MarcinWachowiak/plasma-speaker/README.md

# Plasma-Speaker

https://hackaday.io/project/160041-plasma-speaker-exploring-properties-of-plasma
