MarcinWachowiak/plasma-speaker/Plasma speaker poster.pdf

# “Plasma speaker: Plasma and it's unusual properties”

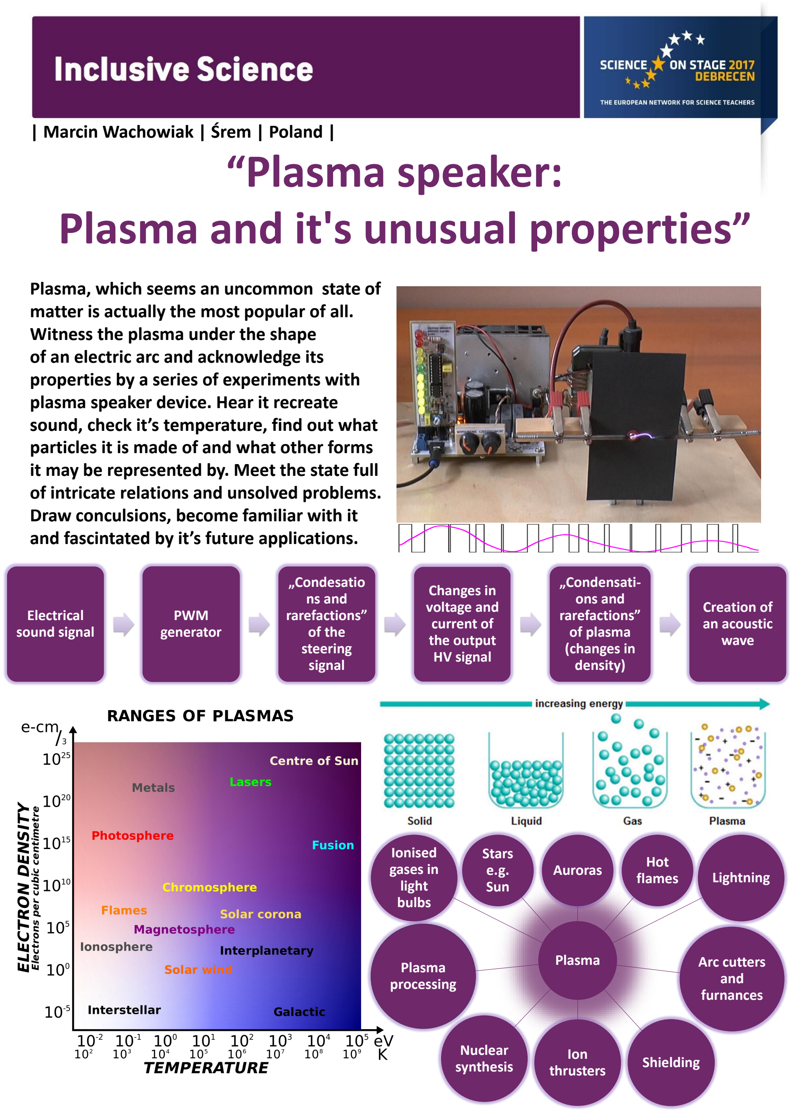
[picture p1: page 1]

| Marcin Wachowiak | Śrem | Poland |

Plasma, which seems an uncommon state of matter is actually the most popular of all. Witness the plasma under the shape
of an electric arc and acknowledge its properties by a series of experiments with plasma speaker device. Hear it recreate sound, check it’s temperature, find out what particles it is made of and what other forms it may be represented by. Meet the state full of intricate relations and unsolved problems. Draw conculsions, become familiar with it and fascintated by it’s future applications.

Electrical
sound signal

PWM
generator

„Condesatio
ns and
rarefactions”
of the
steering
signal

Changes in
voltage and
current of
the output
HV signal

„Condensations and
rarefactions”
of plasma
(changes in
density)

Creation of
an acoustic
wave

Plasma

Hot
flames

Stars
e.g.
Sun

Auroras
Lightning

Ionised
gases in
light
bulbs

Shielding

Plasma
processing

Nuclear
synthesis

Ion
thrusters

Arc cutters
and
furnances
