MarcinWachowiak/plasma-speaker/Plasma speaker presentation.pdf

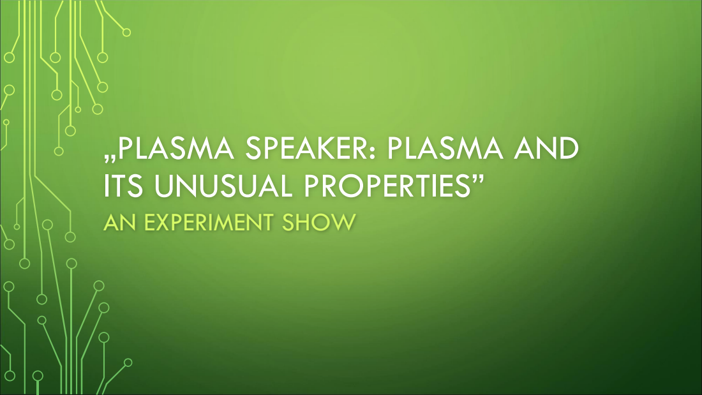
[picture p2: page 1]

„PLASMA SPEAKER: PLASMA AND
ITS UNUSUAL PROPERTIES”
AN EXPERIMENT SHOW

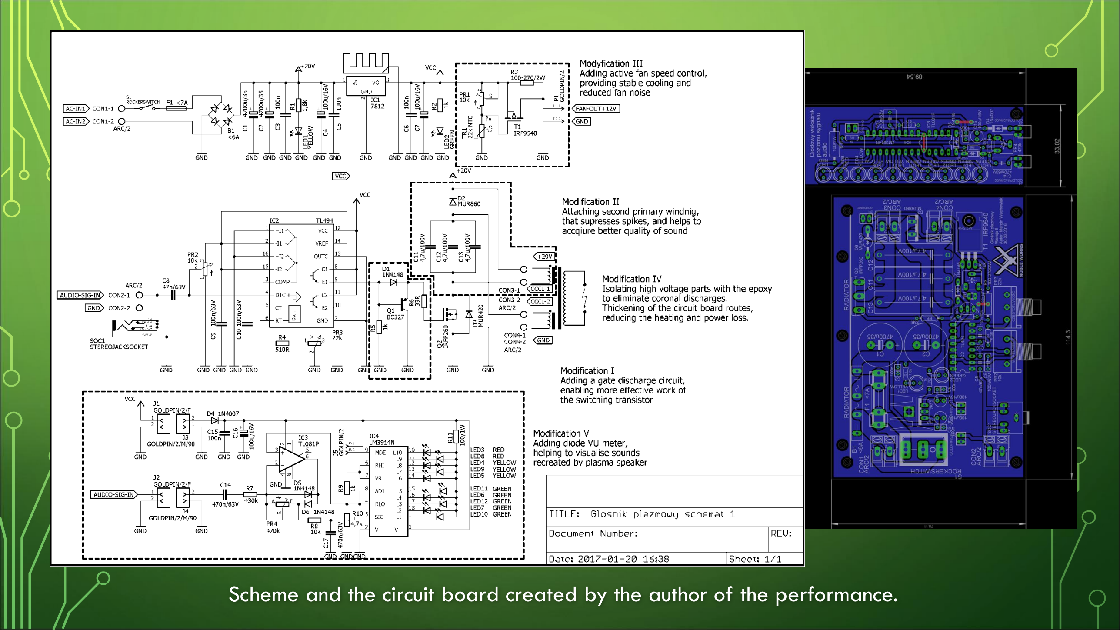
[picture p3: page 2]

Scheme and the circuit board created by the author of the performance.

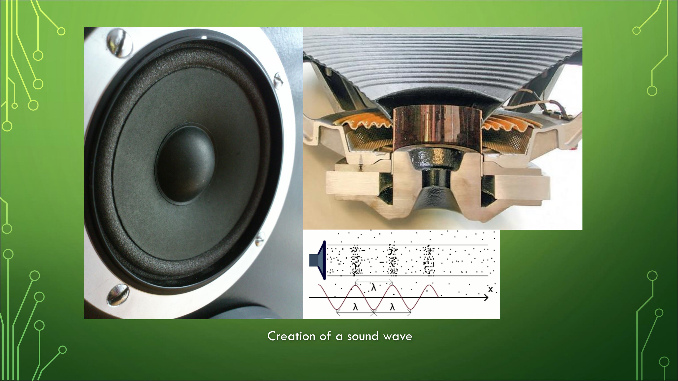
[picture p4: page 3]

## Creation of a sound wave

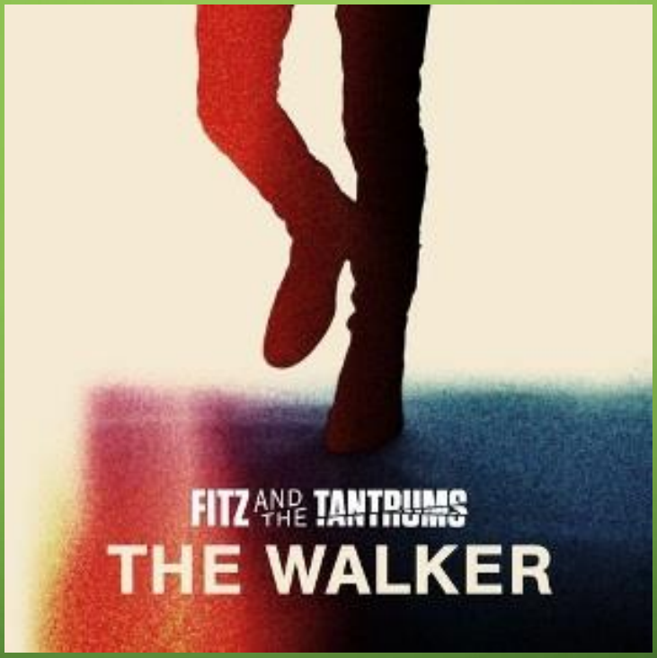
[picture p5: figure]
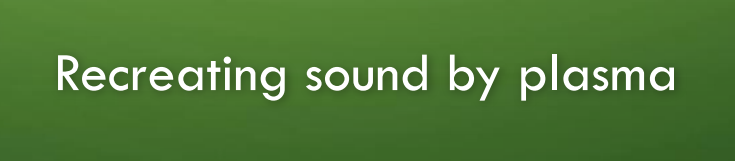
[picture p6: figure]
Recreating sound by plasma
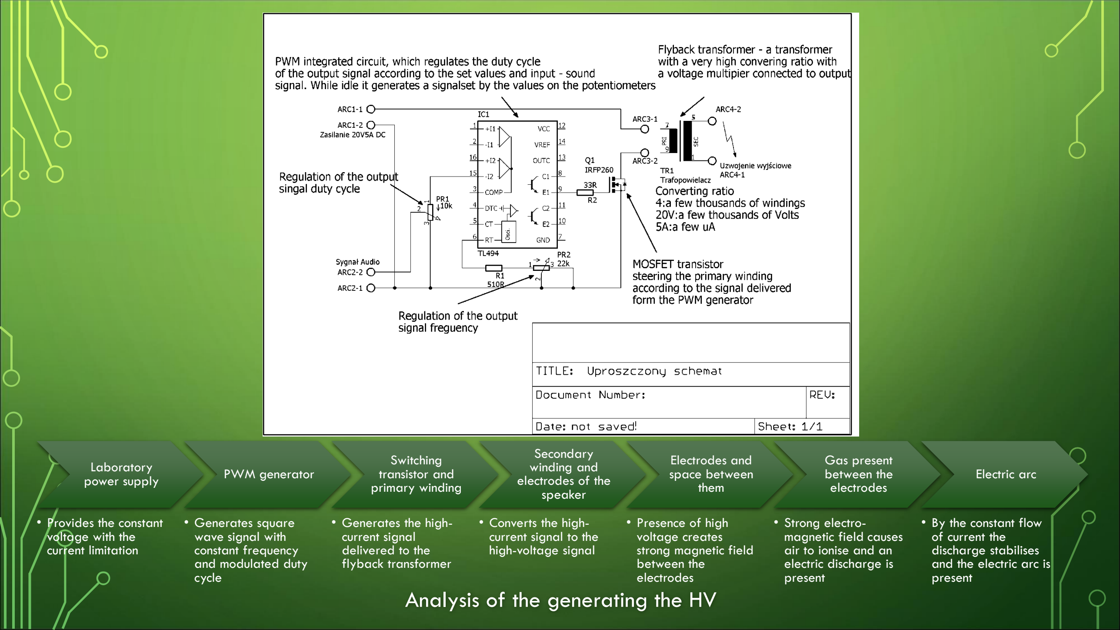
[picture p7: page 5]

Laboratory
power supply
- Provides the constant
voltage with the
current limitation

PWM generator

- Generates square
wave signal with
constant frequency
and modulated duty
cycle

Switching
transistor and
primary winding
- Generates the highcurrent signal
delivered to the
flyback transformer

Secondary
winding and
electrodes of the
speaker
- Converts the highcurrent signal to the
high-voltage signal

Electrodes and
space between
them
- Presence of high
voltage creates
strong magnetic field
between the
electrodes

Gas present
between the
electrodes
- Strong electromagnetic field causes
air to ionise and an
electric discharge is
present

Electric arc

- By the constant flow
of current the
discharge stabilises
and the electric arc is
present

## Analysis of the generating the HV

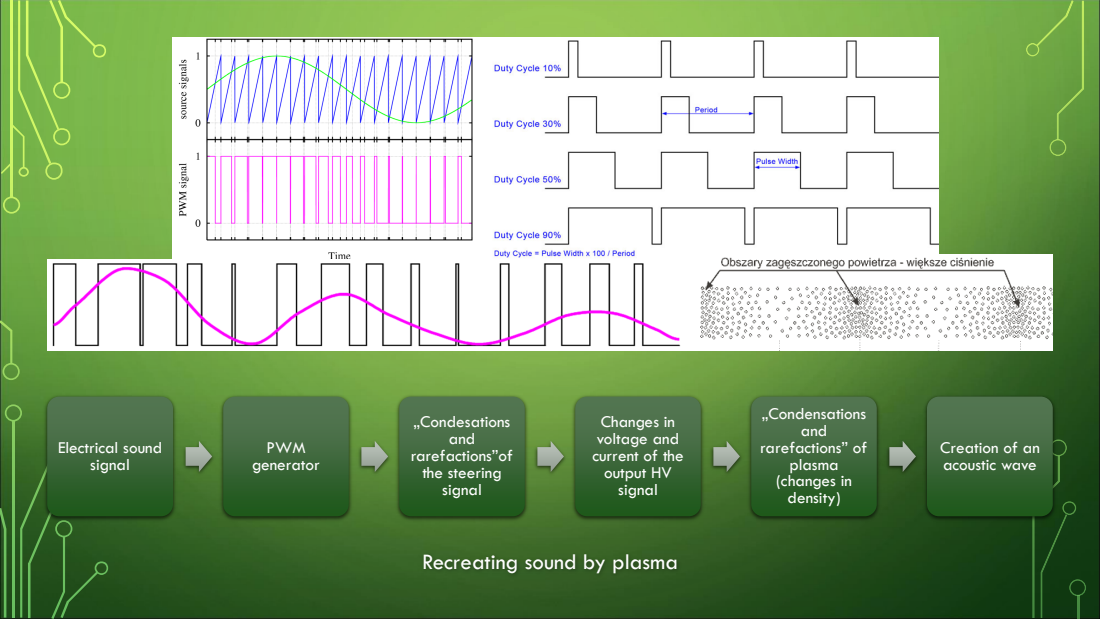
[picture p8: page 6]
Electrical sound signal; PWM generator; „Condesations and rarefactions”of the steering signal; „Condensations and rarefactions” of plasma (changes in density

Changes in
voltage and
current of the
output HV
signal

Creation of an
acoustic wave

Recreating sound by plasma

# Similarities

# Differences

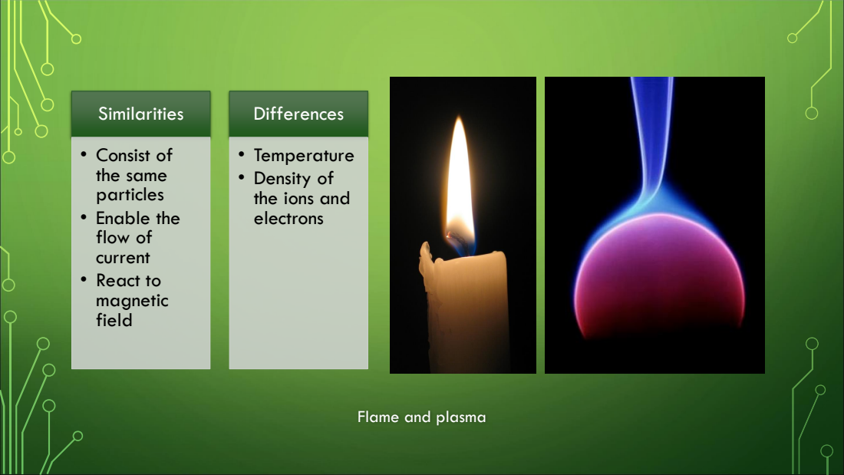
[picture p9: page 7]
• Consist of the same particles • Enable the flow of current • React to magnetic field

• Temperature
• Density of
the ions and
electrons

Flame and plasma

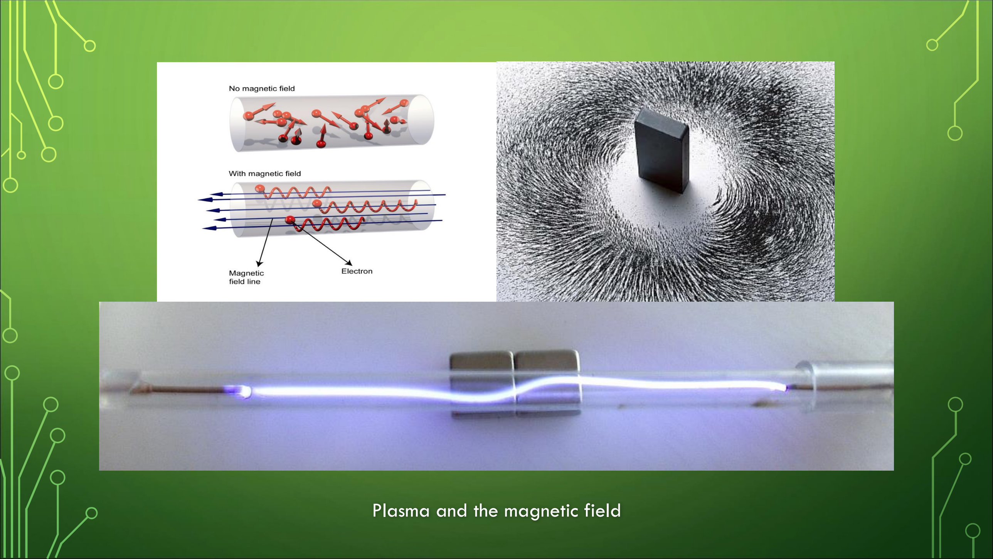
[picture p10: page 8]

## Plasma and the magnetic field

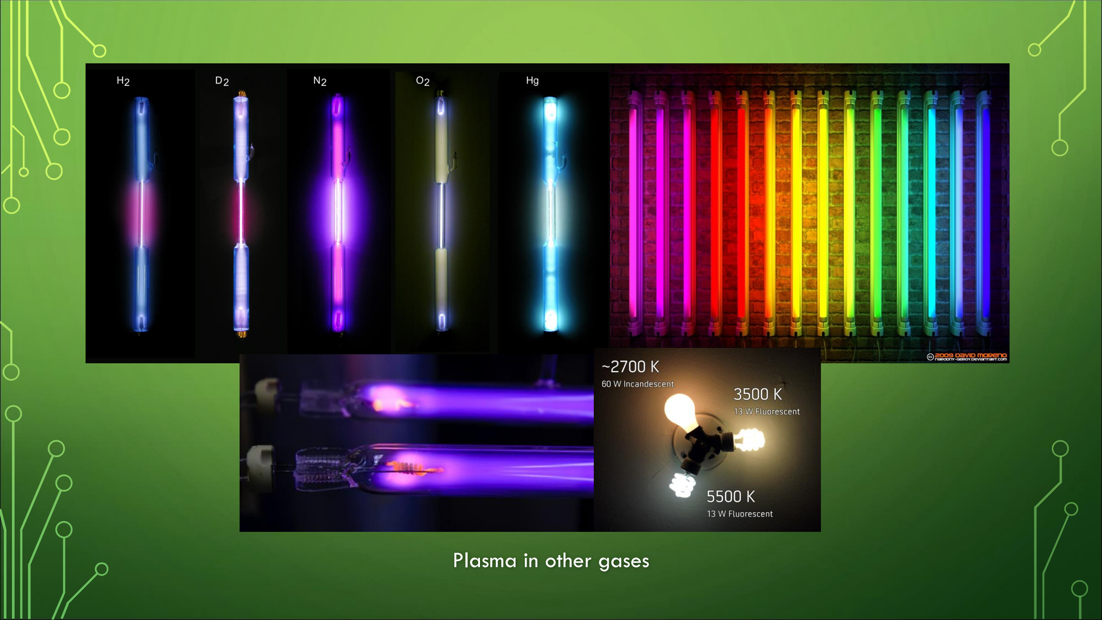
[picture p11: page 9]

## Plasma in other gases

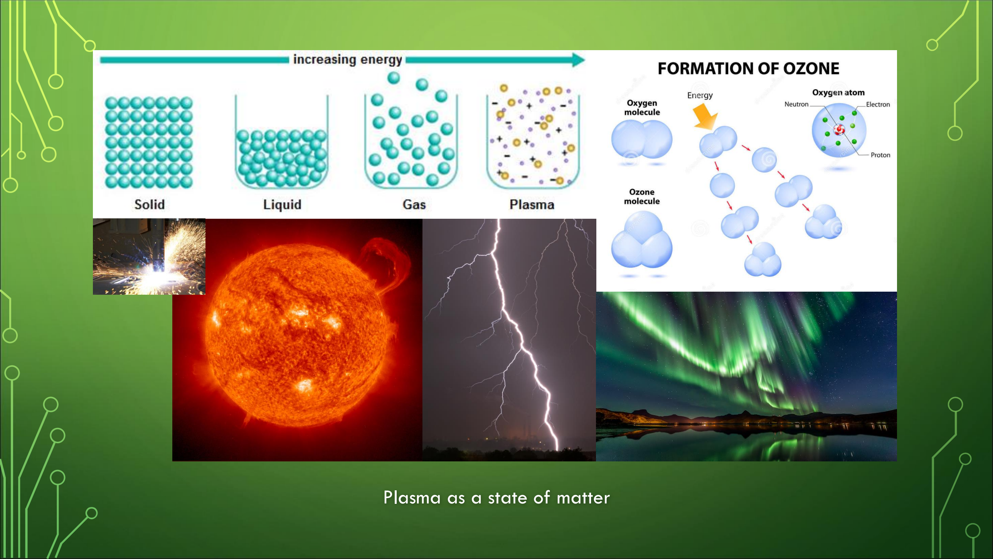
[picture p12: page 10]

## Plasma as a state of matter

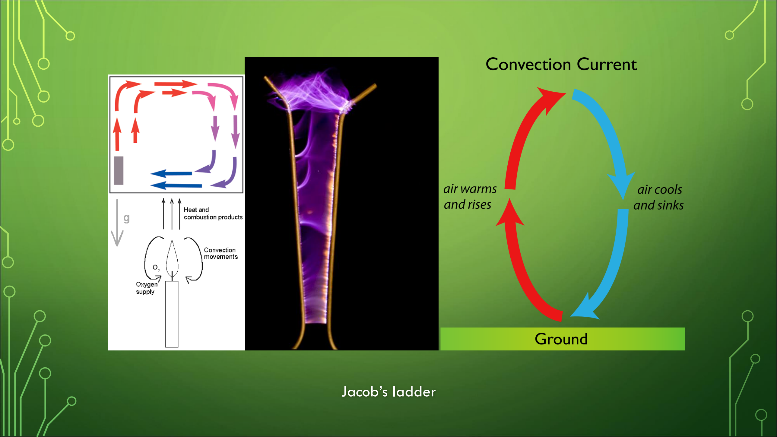
[picture p13: page 11]

## Jacob’s ladder

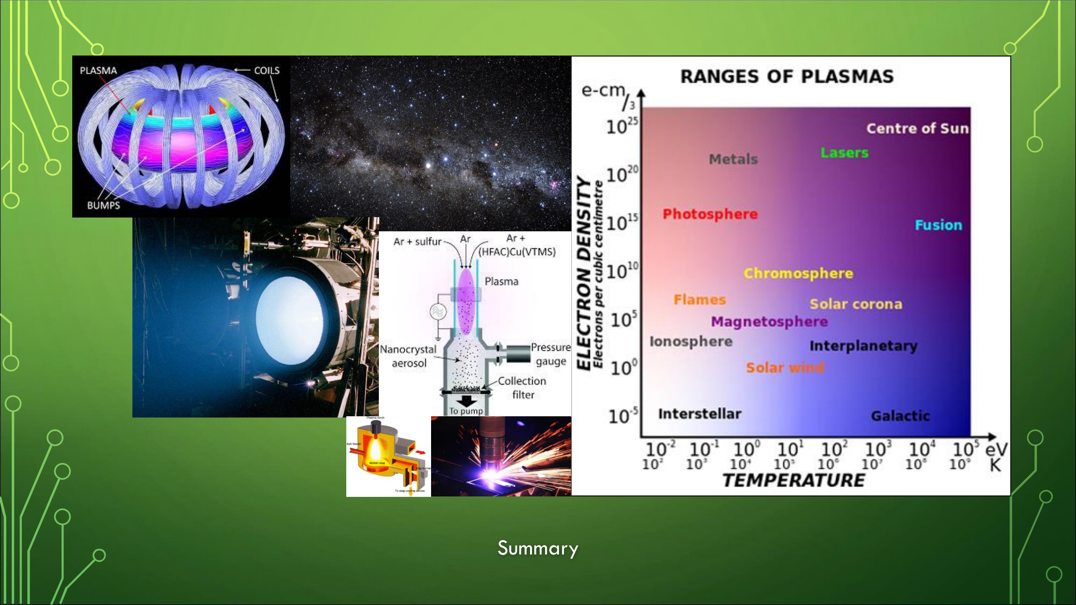
[picture p14: page 12]

## Summary

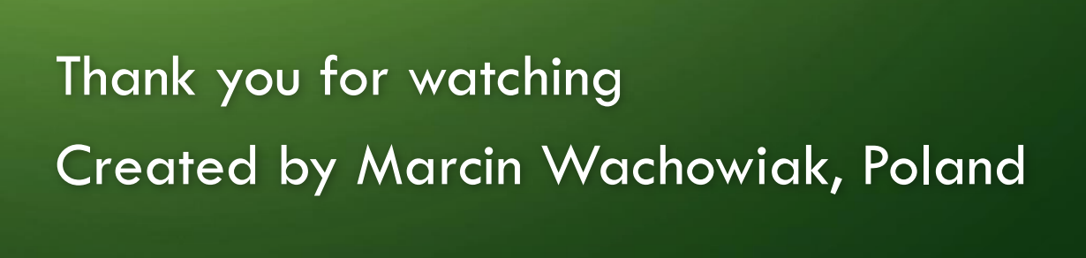
[picture p15: figure]
Thank you for watching; Created by Marcin Wachowiak, Poland
