MarcinWachowiak/plasma-speaker/Brd.png

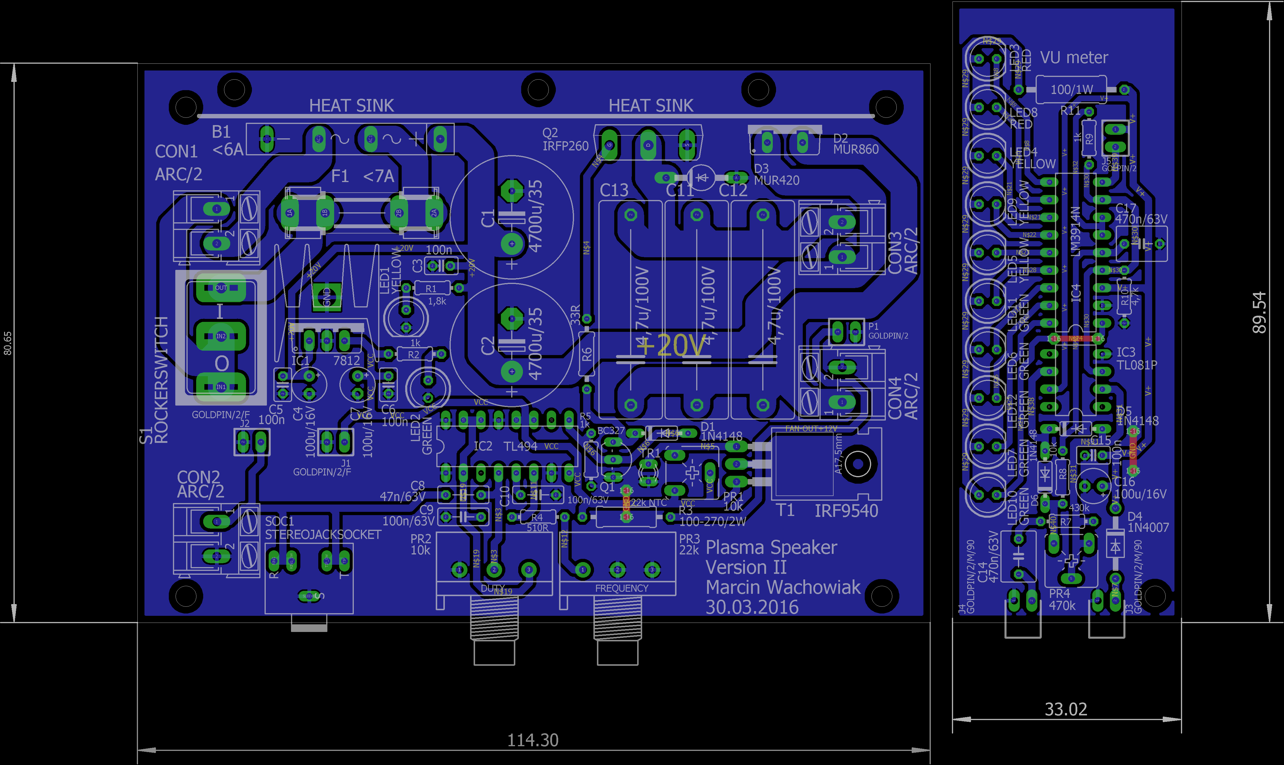
Brd.png
