MarcinWachowiak/plasma-speaker/Sch1.png

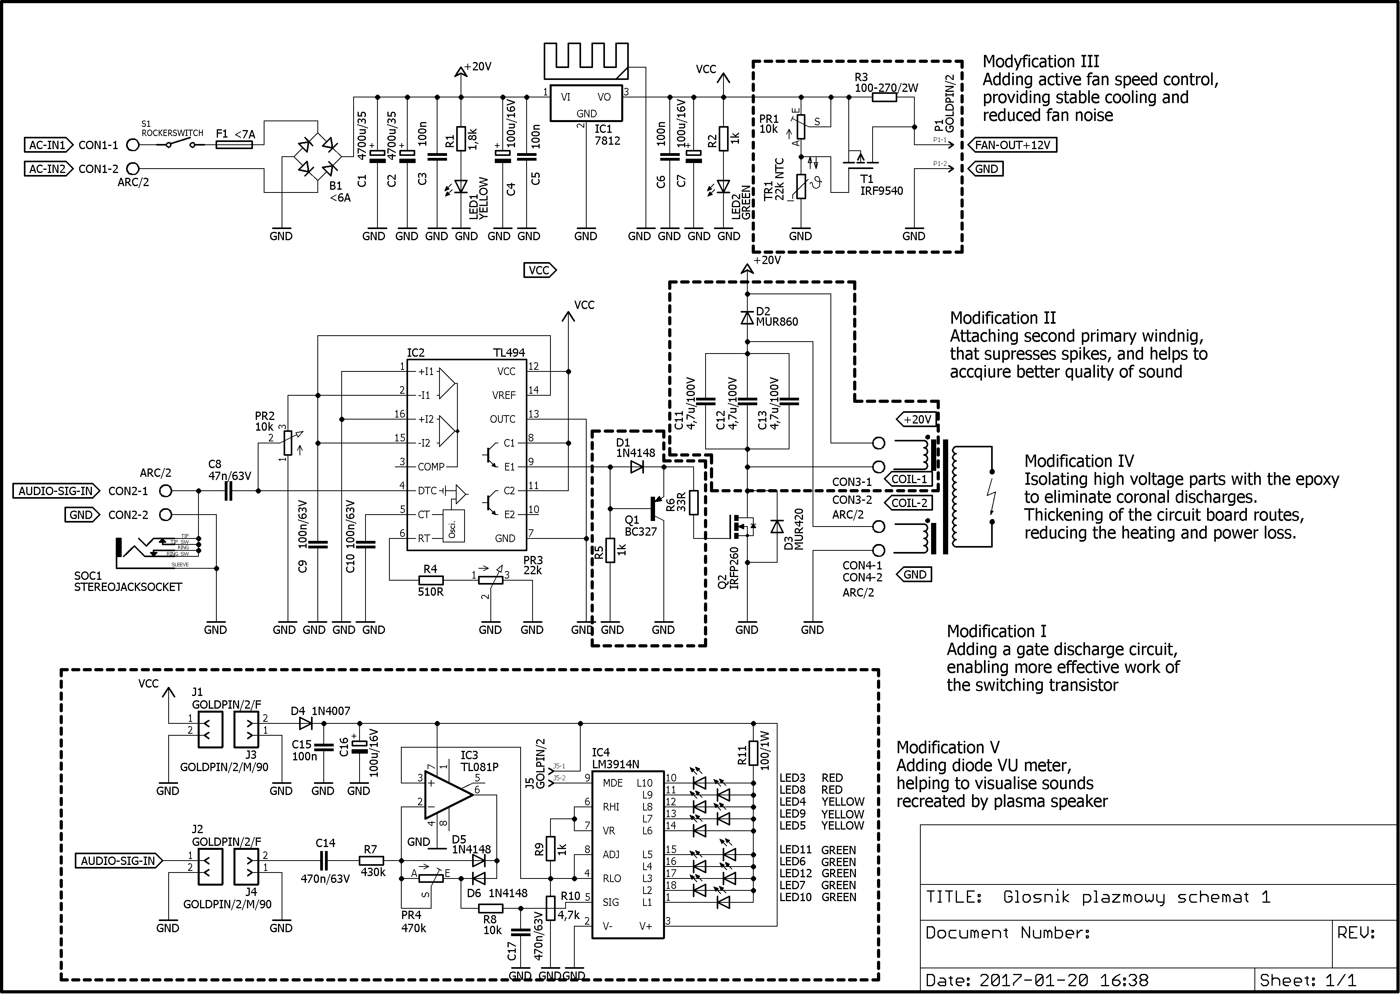
Sch1.png
