MarcinWachowiak/plasma-speaker/Sch2.png

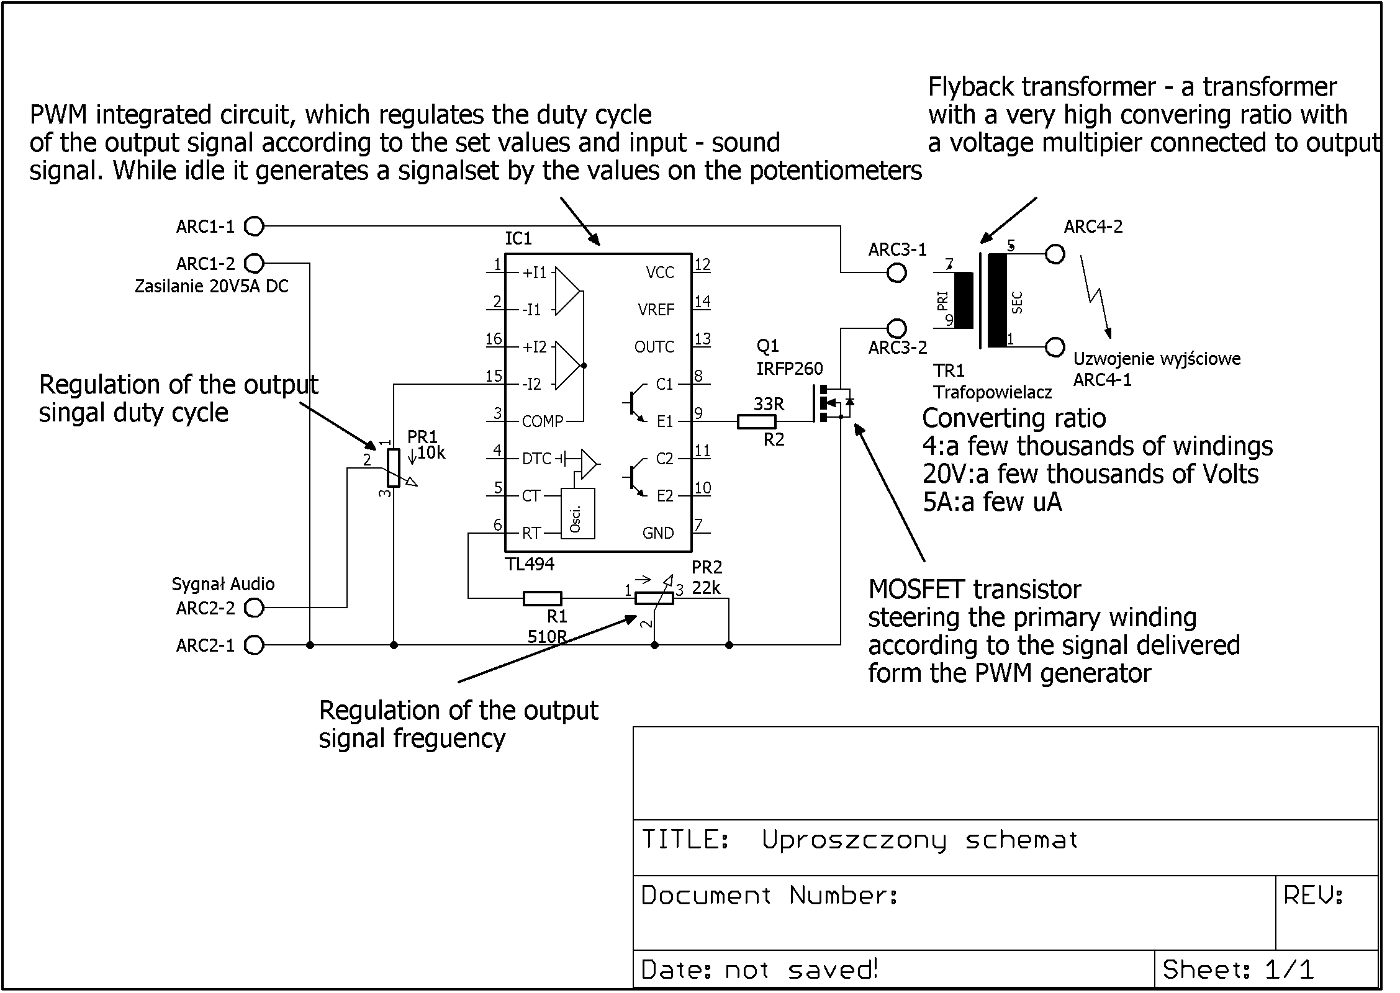
Sch2.png
