MarcinWachowiak/plasma-speaker/Plasma speaker.brd

## EAGLE design Plasma speaker.brd (2018-07-29)

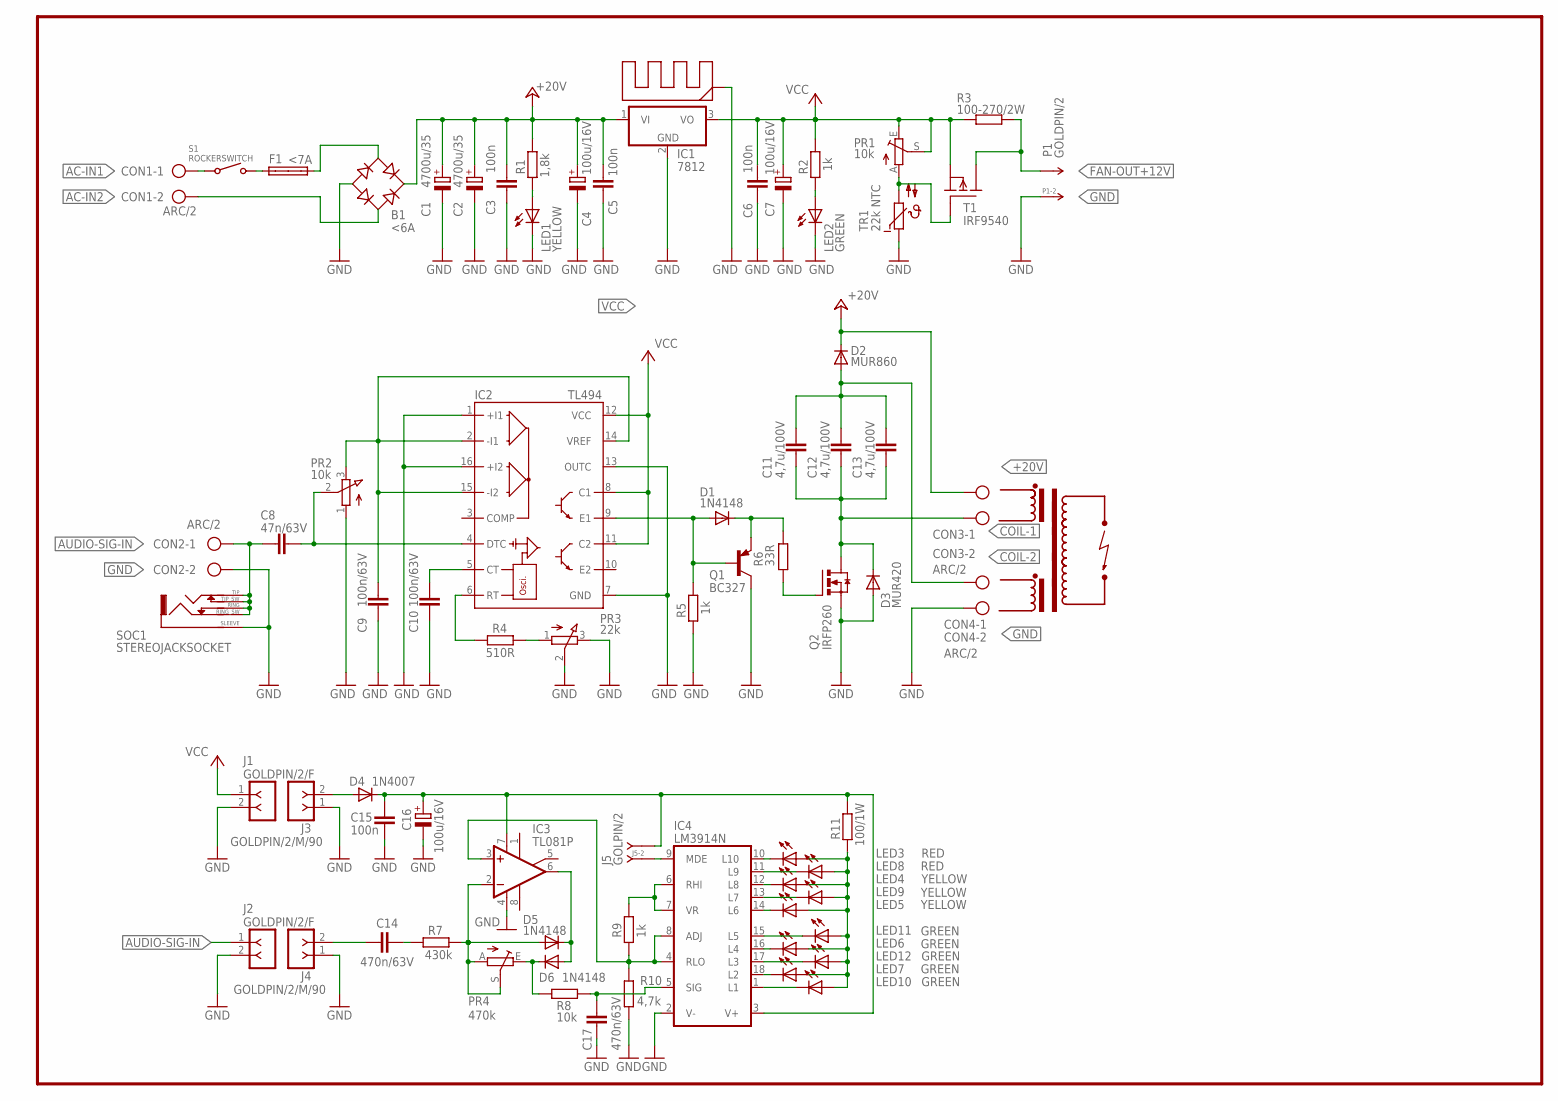
[picture p22: schematic Plasma speaker.sch]

Parts:
B1: <6A; SKB32
C1, C2: 4700u/35; E7,5-18
C3, C5, C6, C15: 100n; C025-025X050
C4, C7, C16: 100u/16V; E2,5-5
C8: 47n/63V; C050-025X075
C9, C10: 100n/63V; C050-025X075
C11, C12, C13: 4,7u/100V; C275-093X316
C14, C17: 470n/63V; C050-050X075
CON1, CON2, CON3, CON4: ARC/2; AK300/2
D1, D5, D6: 1N4148; DO35-7
D2: MUR860; TO220ACS
D3: MUR420; SGA-10
D4: 1N4007; DO41-10
F1: <7A; SHK20L
IC1: 7812; TO220V
IC2: TL494; DIL16
IC3: TL081P; DIL08
IC4: LM3914N; DIL18
J1, J2: GOLDPIN/2/F; SIP-100-02-40Y
J3, J4: GOLDPIN/2/M/90; KK-4455-A02
J5: GOLPIN/2; SIP-100-02-40Y
LED1, LED4, LED5, LED9: YELLOW; LED5MM
LED2, LED6, LED7, LED10, LED11, LED12: GREEN; LED5MM
LED3, LED8: RED; LED5MM
P1: GOLDPIN/2; SIP-100-02-40Y
PR1: 10k; CA6V
PR2: 10k; 3RP/1610N
PR3: 22k; 3RP/1610N
PR4: 470k; CA6V
Q1: BC327; TO92-EBC
Q2: IRFP260; TO247BV
R1: 1,8k; 0204/7
R2, R5, R9: 1k; 0204/7
R3: 100-270/2W; 0309/12
R4: 510R; 0204/7
R6: 33R; 0207/10
R7: 430k; 0204/7
R8: 10k; 0204/7
R10: 4,7k; 0204/7
R11: 100/1W; 0411/15
RAD1: TO3; RADIATOR
S1: ROCKERSWITCH; ROCKER
SOC1: STEREOJACKSOCKET; PICAXE_STEREOJACKSOCKET
T1: IRF9540; TO220
TR1: 22k NTC; P640

Connections:
+20V: B1.+, C1.+, C2.+, C3.1, C4.+, C5.1, CON3.1, D2.C, IC1.1 (VI), R1.1
AC-IN1: CON1.1, S1.IN1 (IN), S1.IN2 (IN)
AC-IN2: B1.AC2, CON1.2
AUDIO-SIG-IN: C8.2, CON2.1, J2.1, SOC1.RING, SOC1.RING_SW (RING-SW), SOC1.TIP, SOC1.TIP_SW (TIP-SW)
COIL-1: C11.2, C12.2, C13.2, CON3.2, D3.C, Q2.D
COIL-2: C11.1, C12.1, C13.1, CON4.1, D2.A
FAN-OUT+12V: P1.1, R3.2, T1.2 (D)
GND: B1.-, C1.-, C2.-, C3.2, C4.-, C5.2, C6.2, C7.-, C9.2, C10.2, C15.2, C16.-, C17.1, CON2.2, CON4.2, D3.A, IC1.2 (GND), IC2.1 (+I1), IC2.7 (GND), IC2.13 (OUTC), IC2.16 (+I2), IC3.4 (V-), IC4.2 (V-), J1.2, J2.2, J3.1, J4.1, LED1.K (C), LED2.K (C), P1.2, PR2.1 (A), PR3.2 (S), PR3.3 (E), Q1.C, Q2.S, R5.1, R10.2, RAD1.GND, SOC1.SLEEVE, TR1.1
unnamed: B1.AC1, F1.2A
unnamed: C14.1, J4.2
unnamed: C8.1, IC2.4 (DTC), PR2.2 (S)
unnamed: Q2.G, R6.1
unnamed: PR1.A, T1.1 (G), TR1.2
unnamed: D1.A, IC2.9 (E1), Q1.B, R5.2
unnamed: D4.A, J3.2
unnamed: IC4.10 (L10), LED3.K (C)
unnamed: C10.1, IC2.5 (CT)
unnamed: IC2.6 (RT), R4.2
unnamed: PR3.1 (A), R4.1
unnamed: D1.C, Q1.E, R6.2
unnamed: F1.1A, S1.OUT
unnamed: LED2.A, R2.2
unnamed: LED1.A, R1.2
unnamed: C9.1, IC2.2 (-I1), IC2.14 (VREF), IC2.15 (-I2), PR2.3 (E)
unnamed: IC4.11 (L9), LED8.K (C)
unnamed: IC4.12 (L8), LED4.K (C)
unnamed: IC4.13 (L7), LED9.K (C)
unnamed: IC4.14 (L6), LED5.K (C)
unnamed: IC4.1 (L1), LED10.K (C)
unnamed: IC4.18 (L2), LED7.K (C)
unnamed: IC4.17 (L3), LED12.K (C)
unnamed: IC4.16 (L4), LED6.K (C)
unnamed: IC4.15 (L5), LED11.K (C)
unnamed: LED3.A, LED4.A, LED5.A, LED6.A, LED7.A, LED8.A, LED9.A, LED10.A, LED11.A, LED12.A, R11.1
unnamed: IC3.3 (+IN), IC4.4 (RLO), IC4.8 (ADJ), R9.2, R10.1
unnamed: D5.A, IC3.2 (-IN), PR4.A, PR4.S, R7.1
unnamed: IC4.6 (RHI), IC4.7 (VR), R9.1
unnamed: C14.2, R7.2
unnamed: D5.C, D6.A, IC3.6 (OUT)
unnamed: IC4.9 (MDE), J5.2
unnamed: D6.C, PR4.E, R8.2
unnamed: C17.2, IC4.5 (SIG), R8.1
V+: C15.1, C16.+, D4.C, IC3.7 (V+), IC4.3 (V+), J5.1, R11.2
VCC: C6.1, C7.+, IC1.3 (VO), IC2.8 (C1), IC2.11 (C2), IC2.12 (VCC), J1.1, PR1.E, PR1.S, R2.1, R3.1, T1.3 (S)

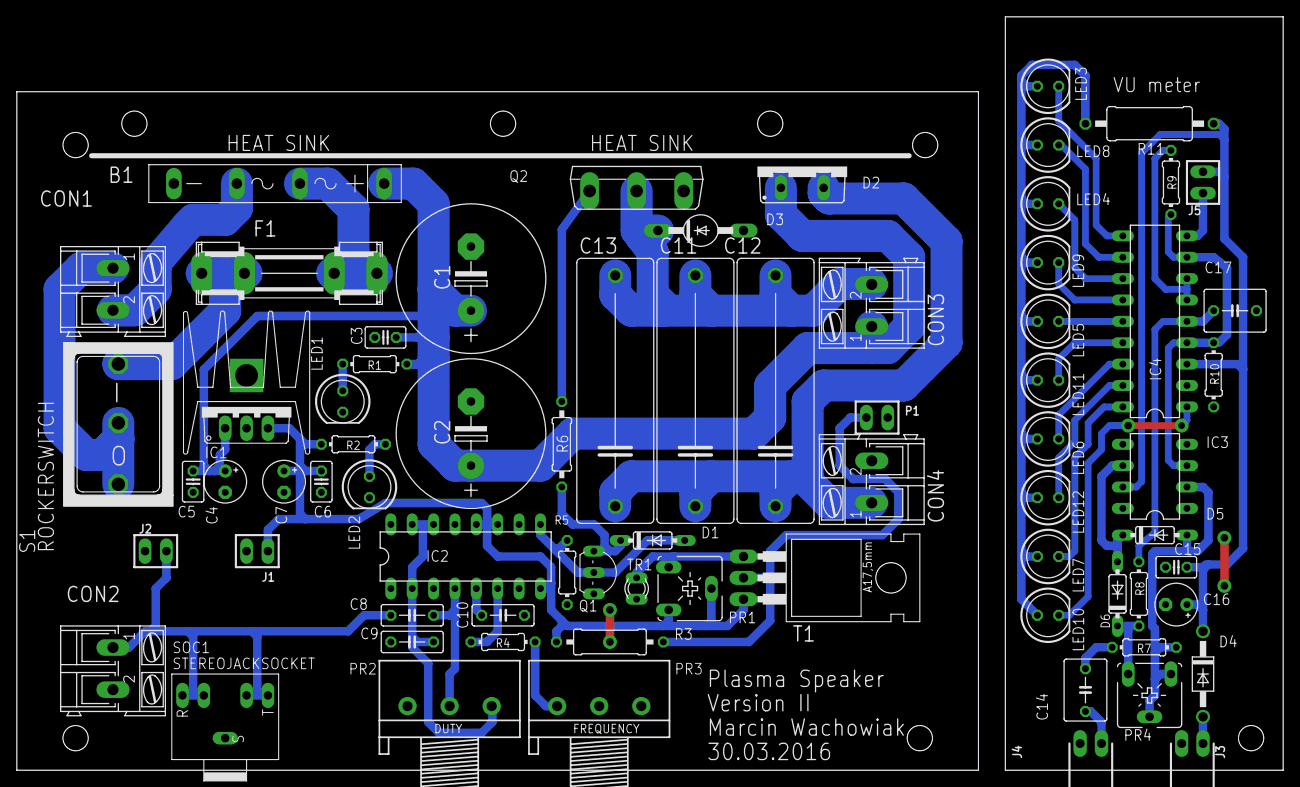
[picture p23: board Plasma speaker.brd from above]

Board: 2 copper layers, 150.5 x 89.5 mm, 73 parts (0 on the bottom side), 44 nets.
